olzhasmametov970-lab/HW2.00/hydrowin/hydrowin/hardware/enclosure/KOMPAS_BY_FUNCTIONS.md

# HydroWin — КОМПАС-3D по функциям

Инструкция по **операциям КОМПАС**: какая функция → что нажать → какие цифры ввести.

Две детали: **низ** (`hydrowin_base.m3d`) и **крышка** (`hydrowin_lid.m3d`).

---

## Быстрая шпаргалка размеров

| Что | Размер |
|---|---|
| Внешний корпус | 155.6 × 77.6 × 44.8 мм |
| Полость внутри | 150 × 72 × 42 мм |
| Стенка / дно | 2.8 мм |
| LilyGO | 110×34, стойки h=10 |
| DC-DC | 66×27, стойки h=4 |
| PG7 | Ø12.8 |
| BNC ×6 | Ø14, шаг 17.5 |
| Саморез крышки | Ø3.4 в крышке, пилот Ø2.3 в низе |

---

# ДЕТАЛЬ 1 — НИЗ КОРПУСА

## Функция 1: Создать деталь

```
Файл → Создать → Деталь
Файл → Сохранить как → hydrowin_base.m3d
```

---

## Функция 2: Эскиз (контур)

**Где:** плоскость **XY** (дно, Z=0).

```
Оформление → Эскиз
  (или: Эскиз → Создать эскиз на плоскости XY)
```

**Что нарисовать:**

| Инструмент | Действие |
|---|---|
| Прямоугольник | 155.6 × 77.6 мм, угол в (0, 0) |
| Размеры | Привязать к началу координат |

```
Эскиз → Завершить создание эскиза
```

---

## Функция 3: Тонкостенный элемент (корпус-оболочка)

```
Операции → Тонкостенный элемент → Выдавить
```

| Поле | Значение |
|---|---|
| Эскиз | только что созданный |
| Высота | **44.8** мм |
| Толщина стенки | **2.8** мм |
| Направление толщины | **внутрь** |

**Результат:** полость 150×72×42 мм.

> **Нет «тонкостенного»?**  
> Выдавливание дна 2.8 мм → на верхней грани эскиз 150×72 со смещением 2.8 → выдавить стенки 42 мм.

---

## Функция 4: Эскиз на плоскости стенки

Повторяется для каждого отверстия в стенке.

### 4а. PG7 — левая стенка (−X)

```
Эскиз → Плоскость грани левой стенки
```

| Параметр | Значение |
|---|---|
| Круг | **Ø12.8** |
| Центр Y | **20.3** |
| Центр Z | **4.55** |

### 4б. USB — левая стенка

| Параметр | Значение |
|---|---|
| Прямоугольник | **10 × 4** мм |
| Центр Y | **56.8** |
| Центр Z | **18.8** |

### 4в. BNC ×6 — задняя стенка (+Y)

| Параметр | Значение |
|---|---|
| Круг | **Ø14** |
| Z центра | **14.8** |
| X центров | 34.05 · 51.55 · 69.05 · 86.55 · 104.05 · 121.55 |

### 4г. SMA ×2 — задняя стенка

| Параметр | Значение |
|---|---|
| Круг | **Ø6.6** |
| Z | **34.8** |
| X | **30.8** и **124.8** |

---

## Функция 5: Выдавливание → Вырезать (сквозные отверстия)

После каждого эскиза на стенке:

```
Операции → Эскивание → Вырезать
```

| Поле | Значение |
|---|---|
| Глубина | **Сквозное** (через всю стенку) |
| Направление | перпендикулярно стенке |

Повторить для PG7, USB, 6× BNC, 2× SMA.

---

## Функция 6: Массив (копии BNC без ручного копирования)

Если рисовали **один** BNC:

```
Операции → Массив → Линейный массив
```

| Поле | Значение |
|---|---|
| Объект | вырез BNC |
| Направление | ось **X** |
| Количество | **6** |
| Шаг | **17.5** мм |
| Смещение первого | X = **34.05** |

> Или 6 отдельных эскизов по таблице X — надёжнее.

---

## Функция 7: Эскиз + Выдавливание → Присоединить (стойки)

**Плоскость:** дно полости (Z = 2.8).

### 7а. Стойки DC-DC (4 шт.)

```
Эскиз → 4 круга Ø6.5
```

| № | X | Y |
|---|---|---|
| 1 | 48.8 | 10.8 |
| 2 | 106.8 | 10.8 |
| 3 | 48.8 | 29.8 |
| 4 | 106.8 | 29.8 |

*(глоб. = внутр. + 2.8)*

```
Операции → Выдавливание → Присоединить
  Высота: 4 мм
  Направление: +Z
```

### 7б. Стойки LilyGO (4 шт.)

Те же операции, круги **Ø6.5**:

| № | X (глоб.) | Y (глоб.) |
|---|---|---|
| 1 | 26.8 | 43.8 |
| 2 | 128.8 | 43.8 |
| 3 | 26.8 | 69.8 |
| 4 | 128.8 | 69.8 |

```
Выдавливание → Присоединить
  Высота: 10 мм
```

---

## Функция 8: Выдавливание → Вырезать (отверстия M3 в стойках)

На верхней грани каждой стойки (или один эскиз со всеми 8 центрами):

```
Эскиз → 8 кругов Ø3.2 в центрах стоек
Операции → Выдавливание → Вырезать → Сквозное
```

---

## Функция 9: Эскиз + Вырезать (канавки в дне)

**Плоскость:** внутреннее дно полости (Z = 2.8).

Канавка = узкий прямоугольник в эскизе → вырез вниз.

### 9а. Питание 24V

| Параметр | Значение |
|---|---|
| Ширина эскиза | **2.6** мм |
| Глубина выреза | **3.0** мм |
| Трасса (центр. линия) | (13.8; 20.3) → (24.8; 20.3) → (24.8; 35) → (62.8; 33.8) |

```
Выдавливание → Вырезать
  Глубина: 3.0 мм
  Направление: −Z (в дно)
```

### 9б. Карман предохранителя

| Параметр | Значение |
|---|---|
| Прямоугольник | **14 × 42** мм |
| Позиция | X=8.8…22.8, Y≈0…42 (глоб.) |
| Глубина | **26** мм вверх (+Z) |

```
Выдавливание → Вырезать
  Направление: +Z (в полость)
```

### 9c. Линия 5V

| Параметр | Значение |
|---|---|
| Ширина | **2.3** |
| Глубина | **2.5** |
| Трасса | (106.8; 10.8) → (106.8; 39.8) → (34.8; 39.8) → (34.8; 47.8) |

### 9d. Сигнальные ×6

| Параметр | Значение |
|---|---|
| Ширина | **1.5** |
| Глубина | **1.8** |
| Шаг | **3.0** |
| X центров (глоб.) | 56.55 · 59.55 · 62.55 · 65.55 · 68.55 · 71.55 |
| Направление | от платы (Y≈74) к BNC (Y≈65) |

### 9e. Карман резистора (на каждой линии)

| Параметр | Значение |
|---|---|
| Размер | **8 × 3** мм |
| Глубина | **3.0** |
| Позиция | у кромки платы на каждой из 6 линий |

### 9f. Канавки BNC

| Параметр | Значение |
|---|---|
| Ширина | **3.0** |
| Глубина | **3.2** |
| Количество | 6 вертикальных к задней стенке |

---

## Функция 10: Скругление (Fillet) — повороты канавок

```
Операции → Сопряжение → Скругление
```

| Поле | Значение |
|---|---|
| Рёбра | внешние углы канавок на поворотах |
| Радиус | **R4** мм (минимум) |

> На эскизе канавки можно сразу рисовать с дугами R4.

---

## Функция 11: Эскиз + Вырезать (жалюзи DC-DC)

**Зона в полу:** X=47.8…107.8, Y=9.8…30.8 (глоб.).

```
Эскиз → несколько узких прямоугольников под углом 45°
  Толщина ламели (остаётся): 1.5 мм
  Зазор (вырезается): 2.0 мм
```

```
Выдавливание → Вырезать
  Глубина: 2.8 мм (сквозь дно) или 2.0 мм
```

*Ламели остаются — вырезаете только щели между ними.*

---

## Функция 12: Карман / паз (уплотнитель на буртике)

**Плоскость:** верхний торец стенок (Z = 44.8).

```
Эскиз → контур по периметру, отступ от края 4.2 мм
  Ширина паза: 2.8 мм
```

```
Выдавливание → Вырезать
  Глубина: 2.0 мм
  Направление: −Z
```

---

## Функция 13: Отверстие / вырез (пилоты под саморез)

**Плоскость:** верхний буртик.

```
Эскиз → 4 круга Ø2.3
```

| Угол | X | Y |
|---|---|---|
| 1 | 8 | 8 |
| 2 | 147.6 | 8 |
| 3 | 8 | 69.6 |
| 4 | 147.6 | 69.6 |

```
Выдавливание → Вырезать
  Глубина: 8 мм (НЕ сквозное)
```

---

## Функция 14: Сохранить деталь

```
Файл → Сохранить
```

---

# ДЕТАЛЬ 2 — КРЫШКА

## Функция 15: Создать деталь

```
Файл → Создать → Деталь → hydrowin_lid.m3d
```

---

## Функция 16: Эскиз + Присоединить (пластина)

```
Эскиз на XY → прямоугольник 155.6 × 77.6
Выдавливание → Присоединить → высота 3.2 мм
```

---

## Функция 17: Эскиз + Вырезать (губа)

**Плоскость:** нижняя грань крышки.

```
Эскиз → контур 150.7 × 72.7, смещение 2.45 от края
Выдавливание → Вырезать → глубина 2.0 мм вниз (−Z)
```

---

## Функция 18: Эскиз + Вырезать (отверстия крышки)

```
Эскиз → 4 круга Ø3.4 в углах (таблица из Функции 13)
Выдавливание → Вырезать → Сквозное
```

---

## Функция 19: Сохранить крышку

```
Файл → Сохранить
```

---

# СБОРКА

## Функция 20: Создать сборку

```
Файл → Создать → Сборка → hydrowin_asm.a3d
```

---

## Функция 21: Вставить компонент

```
Вставка → Компонент → Добавить из файла
  → hydrowin_base.m3d
  → hydrowin_lid.m3d
```

---

## Функция 22: Смещение / положение компонента

Выделить крышку:

```
Преобразования → Смещение (или Массив компонентов → Переместить)
  Ось Z: +44.8 мм
```

Проверить надевание на буртик.

---

## Функция 23: Измерение (контроль)

```
Измерения → Расстояние
```

| Что проверить | Должно быть |
|---|---|
| Внутренняя длина | 150 мм |
| Внутренняя ширина | 72 мм |
| PG7 напротив DC-DC | Y ≈ 20 |
| BNC на одной линии | Z = 14.8 |

---

## Функция 24: Экспорт STL (для печати)

```
Файл → Сохранить как → STL
```

| Деталь | Ориентация в слайсере |
|---|---|
| hydrowin_base | дном вниз |
| hydrowin_lid | внешней стороной вверх |

---

# Порядок операций (чеклист)

### Низ
- [ ] **1** Создать деталь
- [ ] **2–3** Эскиз + Тонкостенный элемент (корпус)
- [ ] **4–5** Эскизы на стенках + Вырезать (PG7, USB, BNC, SMA)
- [ ] **6** Массив BNC (опционально)
- [ ] **7–8** Стойки: Присоединить + Вырезать M3
- [ ] **9** Канавки и карманы: Вырезать
- [ ] **10** Скругление R4 на канавках
- [ ] **11** Жалюзи
- [ ] **12** Паз уплотнителя
- [ ] **13** Пилоты саморезов
- [ ] **14** Сохранить

### Крышка
- [ ] **15–16** Деталь + пластина
- [ ] **17** Губа
- [ ] **18** Отверстия Ø3.4
- [ ] **19** Сохранить

### Сборка
- [ ] **20–22** Сборка + вставка + смещение крышки
- [ ] **23** Измерения
- [ ] **24** STL → печать

---

# Схема (вид сверху, глоб. координаты)

```
  Y=77.6  ○SMA(30.8)              ○SMA(124.8)
          ○BNC  ○    ○    ○    ○    ○
  ┌──────────────────────────────────────────┐ X=155.6
  │         LilyGO  X=22.8…132.8             │
  │         DC-DC   X=44.8…110.8             │
  │                    ////жалюзи////         │
  └──────────────────────────────────────────┘
  ○PG7(12.8) Y=20.3          ○USB Y=56.8
  X=0
```

---

# Связанные файлы

| Файл | Содержание |
|---|---|
| [KOMPAS_CREATE_PART.md](KOMPAS_CREATE_PART.md) | Полные таблицы координат |
| [KOMPAS_ASSEMBLY.md](KOMPAS_ASSEMBLY.md) | Импорт готовых STL |
| [BUILD_FROM_SCRATCH.md](BUILD_FROM_SCRATCH.md) | OpenSCAD + печать |
| [POWER_WIRING.md](../../firmware/POWER_WIRING.md) | Проводка |
