olzhasmametov970-lab/HW2.00/hydrowin/hydrowin/hardware/enclosure/KOMPAS_CREATE_PART.md

# HydroWin — создать корпус в КОМПАС-3D с нуля

Полная инструкция: как **создать деталь**, нарисовать корпус, вырезать канавки и собрать.  
Все размеры взяты из модели проекта (`hydrowin_enclosure.scad`).

---

## Содержание

1. [Система координат](#1-система-координат)
2. [Сводная таблица размеров](#2-сводная-таблица-размеров)
3. [Деталь 1 — низ корпуса (base)](#3-деталь-1--низ-корпуса-base)
4. [Деталь 2 — крышка (lid)](#4-деталь-2--крышка-lid)
5. [Сборка](#5-сборка)
6. [Альтернатива — импорт STL](#6-альтернатива--импорт-stl)

---

## 1. Система координат

В КОМПАС при создании детали:

| Ось | Направление |
|---|---|
| **X** | Длина корпуса (150 мм внутри) |
| **Y** | Ширина (72 мм внутри) |
| **Z** | Высота (вверх) |

**Ноль (0,0,0)** — нижний левый внешний угол дна корпуса (передний левый угол при виде сбоку).

```
        Y (ширина 77.6)
        ↑
        │   ┌──────────────────┐  ← задняя стенка (BNC)
        │   │                  │
        └───┘                  │
       X (длина 155.6) ────────→

  Z вверх — от дна наружу
```

**Внутренняя полость** начинается в точке **(2.8 ; 2.8 ; 2.8)** — это смещение стенки и дна.

Все координаты ниже для **внутренней полости** даны **от внутреннего угла** (X=2.8, Y=2.8, Z=2.8).  
Чтобы получить **глобальную** координату КОМПАС: **прибавьте 2.8** к X, Y и Z.

---

## 2. Сводная таблица размеров

### Корпус

| Параметр | мм |
|---|---|
| Внутренняя длина × ширина × высота | **150 × 72 × 42** |
| Толщина стенок | **2.8** |
| Толщина дна | **2.8** |
| Внешние габариты низа | **155.6 × 77.6 × 44.8** |

### Платы (зоны монтажа)

| Компонент | Размер | Позиция (внутр. X, Y от угла полости) |
|---|---|---|
| DC-DC | 66 × 27 × 10 | X=42…108, Y=4…31 |
| LilyGO | 110 × 34 × 18 | X=20…130, Y=37…71 |

### Стойки M3

| | Ø наружный | Высота | Ø отверстия |
|---|---|---|---|
| Под LilyGO | 6.5 | **10** | 3.2 |
| Под DC-DC | 6.5 | **4** | 3.2 |

**Центры стоек LilyGO** (внутр. координаты):

| № | X | Y |
|---|---|---|
| 1 | 24 | 41 |
| 2 | 126 | 41 |
| 3 | 24 | 67 |
| 4 | 126 | 67 |

*(Если отверстия на вашей плате другие — замерьте и сдвиньте; в модели отступ от края PCB = 4 мм.)*

**Центры стоек DC-DC** (внутр. координаты):

| № | X | Y |
|---|---|---|
| 1 | 46 | 8 |
| 2 | 104 | 8 |
| 3 | 46 | 27 |
| 4 | 104 | 27 |

### Отверстия в стенках

| Элемент | Ø / размер | Позиция |
|---|---|---|
| **PG7** (левая стенка, −X) | **Ø12.8** | Y=**20.3**, Z=**4.55** (глоб.) |
| **USB** (левая стенка) | 10 × 4 мм | Y=**56.8**, Z=**18.8** (глоб.) |
| **BNC ×6** (задняя стенка, +Y) | **Ø14** | Z центра = **14.8** (глоб.) |
| **SMA LTE** | **Ø6.6** | X=**30.8**, Z=**34.8** (глоб.) |
| **SMA GPS** | **Ø6.6** | X=**124.8**, Z=**34.8** (глоб.) |

**BNC по X** (центры, внутр. координата → глоб. X = +2.8):

| BNC | Внутр. X | Глоб. X |
|---|---|---|
| 1 | 31.25 | 34.05 |
| 2 | 48.75 | 51.55 |
| 3 | 66.25 | 69.05 |
| 4 | 83.75 | 86.55 |
| 5 | 101.25 | 104.05 |
| 6 | 118.75 | 121.55 |

Шаг BNC: **17.5 мм**.

### Кабельные канавки (вырезать из дна полости)

| Линия | Ширина | Глубина |
|---|---|---|
| Питание 24V | 2.6 | 3.0 |
| 5V | 2.3 | 2.5 |
| Сигнал ×6 | 1.5 | 1.8 (шаг 3.0) |
| BNC | 3.0 | 3.2 |
| Скругление поворотов | R ≥ **4.0** | |

**Карман предохранителя:** 42 × 14 × 26 мм (внутр. X=6…20, Y≈−3.5…38.5 относительно pg7_y).  
**Карман резистора** (на каждой сигнальной линии): 8 × 3 × 3 мм.

### Крышка

| Параметр | мм |
|---|---|
| Пластина | 155.6 × 77.6 × **3.2** |
| Губа внутрь | глубина **2.0**, зазор **0.35** |
| Отверстия под саморез | **Ø3.4**, отступ от угла **8** |
| Пилоты в буртике низа | **Ø2.3**, глубина **8** |

### Жалюзи DC-DC (в полу)

| Параметр | мм |
|---|---|
| Зона | над DC-DC: X=45…105, Y=7…28 (внутр.) |
| Ламель | толщина **1.5** |
| Зазор | **2.0** |
| Угол | **45°** |

---

## 3. Деталь 1 — низ корпуса (base)

### Шаг 3.1. Создать деталь

1. Запустите **КОМПАС-3D**.
2. **Файл → Создать → Деталь** (или иконка «Новая деталь»).
3. **Файл → Сохранить как** → `hydrowin_base.m3d`.

### Шаг 3.2. Корпус-оболочка (тонкостенный или выдавливание)

**Способ A — тонкостенный элемент (удобнее):**

1. Плоскость **XY** (дно) → **Эскиз**.
2. Нарисуйте прямоугольник **155.6 × 77.6** мм (внешний контур).
3. **Операции → Тонкостенный элемент → Выдавить**.
4. Высота: **44.8** мм.
5. Толщина стенки: **2.8** мм, направление **внутрь**.

**Способ B — два выдавливания:**

1. Эскиз **155.6 × 77.6** → выдавить **2.8** мм (дно).
2. На верхней грани дна эскиз внутреннего контура **150 × 72** со смещением **2.8** от краёв.
3. Выдавить вверх **42** мм (стенки).

Проверка: внутренняя полость **150 × 72 × 42** мм.

### Шаг 3.3. Отверстие PG7 (24V, левая стенка)

1. Плоскость левой наружной стенки (или эскиз на YZ при X=0).
2. Точка центра: **Y = 20.3**, **Z = 4.55** мм (глобальные).
3. Круг **Ø12.8** мм.
4. **Операции → Выдавливание → Вырезать** сквозь стенку.

> Вокруг отверстия **не делайте** канавок на стенке в зоне **R10 мм** — нужна гладкая площадка под шайбу сальника.

### Шаг 3.4. Слот USB (левая стенка)

1. На той же стенке прямоугольник **10 × 4** мм.
2. Центр: **Y = 56.8**, **Z = 18.8** (глоб.).
3. Вырезать сквозь стенку.

### Шаг 3.5. Отверстия BNC (задняя стенка, Y = 77.6)

1. Плоскость задней стенки.
2. 6 кругов **Ø14** мм по таблице X выше.
3. Центр по высоте: **Z = 14.8** мм от низа детали.
4. Вырезать сквозь стенку.

### Шаг 3.6. Отверстия SMA (задняя стенка)

1. Два круга **Ø6.6** мм.
2. Центры: **(30.8 ; 77.6 ; 34.8)** и **(124.8 ; 77.6 ; 34.8)** (глоб.).
3. Сквозное вырезание.

### Шаг 3.7. Стойки под DC-DC

Для каждого из 4 центров (46,8), (104,8), (46,27), (104,27):

1. Эскиз круга **Ø6.5** на **дне полости** (плоскость Z = 2.8).
2. **Присоединить** → выдавить **4** мм вверх.
3. **Вырезать** в стойке отверстие **Ø3.2** сквозь.

### Шаг 3.8. Стойки под LilyGO

То же для центров (24,41), (126,41), (24,67), (126,67):

1. Круг **Ø6.5**.
2. Высота **10** мм.
3. Отверстие **Ø3.2**.

### Шаг 3.9. Канавка питания 24V

На **дне полости** (внутренняя горизонтальная грань, Z = 2.8):

1. Эскиз прямоугольника шириной **2.6** мм (или профиль канала).
2. Трасса (центральная линия):
   - от зоны PG7: **(11 ; 17.5)** → **(22 ; 17.5)** → **(22 ; центр кармана)** → **(60 ; 31)** (вход DC-DC).
3. **Вырезать** глубиной **3.0** мм вниз (в тело дна).
4. Повороты скруглить **R4**.

### Шаг 3.10. Карман предохранителя

1. На дне полости прямоугольник **14 × 42** мм (или 42 × 14 по ориентации).
2. Позиция: X=6…20, Y≈−3.5…38.5 от внутреннего угла (центр у PG7/DC-DC).
3. **Вырезать** глубиной **26** мм вверх в полость (карман открыт сверху).

### Шаг 3.11. Канавка 5V

- Ширина **2.3**, глубина **2.5**.
- От DC-DC **(104 ; 8)** → вверх по Y → к плате **(32 ; 37)**.
- Скругления R4.

### Шаг 3.12. 6 сигнальных канавок

- Ширина **1.5**, глубина **1.8**, шаг **3.0**.
- 6 параллельных линий от задней кромки платы (Y≈71) к линии BNC.
- Центры X: **53.75, 56.75, 59.75, 62.75, 65.75, 68.75** (внутр.).
- На каждой линии у платы — карман резистора **8 × 3 × 3** мм с плавным переходом.

### Шаг 3.13. Канавки к BNC

- Ширина **3.0**, глубина **3.2**.
- От шины сигналов вертикально к каждому BNC (6 шт.).

### Шаг 3.14. Жалюзи в полу (DC-DC)

1. На дне в зоне DC-DC вырежьте «окно» (или серию щелей).
2. Оставьте ламели **1.5** мм толщиной, зазор **2.0** мм, угол **45°**.
3. Ламели ориентируйте так, чтобы снизу не было прямого просмотра внутрь.

*Упрощение:* можно сделать 8–10 параллельных щелей под углом 45° в прямоугольнике 60×21 мм (X=45…105, Y=7…28 внутр.).

### Шаг 3.15. Паз под уплотнитель (буртик)

На верхнем торце стенок:

1. Паз шириной **2.8**, глубиной **2.0** мм.
2. Отступ от внешнего края **4.2** мм по периметру.

### Шаг 3.16. Пилоты под саморезы крышки

В верхнем буртике, от углов с отступом **8** мм:

1. 4 отверстия **Ø2.3** мм.
2. Глубина **8** мм (не сквозные).

### Шаг 3.17. Сохранить

**Файл → Сохранить** — `hydrowin_base.m3d`.

---

## 4. Деталь 2 — крышка (lid)

### Шаг 4.1. Новая деталь

**Файл → Создать → Деталь** → `hydrowin_lid.m3d`.

### Шаг 4.2. Пластина

1. Эскиз **155.6 × 77.6** на XY.
2. Выдавить **3.2** мм вверх.

### Шаг 4.3. Губа (внутренний борт)

1. На нижней грани эскиз контура **150.7 × 72.7** (150+0.35×2) со смещением **2.45** от края.
2. **Выдавить** вниз **2.0** мм (губа входит в полость).

### Шаг 4.4. Отверстия под саморезы

1. 4 круга **Ø3.4** мм.
2. Центры: **(8 ; 8)**, **(147.6 ; 8)**, **(8 ; 69.6)**, **(147.6 ; 69.6)** от угла детали.
3. Сквозное вырезание.

### Шаг 4.5. Сохранить

`hydrowin_lid.m3d`.

---

## 5. Сборка

1. **Файл → Создать → Сборка** → `hydrowin_asm.a3d`.
2. **Вставка → Компонент → Из файла** → `hydrowin_base.m3d`.
3. Вставить `hydrowin_lid.m3d`.
4. Сместить крышку по **Z = +44.8** мм (надеть на корпус) или **+2…3** мм (зазор для вида).
5. Проверить:
   - PG7 напротив DC-DC
   - BNC на одной линии
   - стойки внутри зон плат
6. **Сохранить сборку**.

### Проверка посадки плат (опционально)

Создайте временные блоки:

| Блок | Размер | Низ блока (Z) |
|---|---|---|
| DC-DC | 66×27×10 | 2.8+4 = **6.8** |
| LilyGO | 110×34×18 | 2.8+10 = **12.8** |

Если блок пересекает стенку — сдвиньте стойки.

---

## 6. Альтернатива — импорт STL

Если не хотите рисовать вручную — в проекте уже есть готовые STL:

```
hardware/enclosure/
  hydrowin_base.stl    ← низ
  hydrowin_lid.stl     ← крышка
```

**Вставка → Деталь → Из внешнего файла** → выбрать STL, единицы **мм**.

Пересборка STL из OpenSCAD:

```powershell
cd C:\Users\Admin2\Desktop\HW2.0\hydrowin\hydrowin\hardware\enclosure
.\export-stl.ps1
```

---

## Схема расположения (вид сверху, внутр. полость)

```
  задняя стенка Y=72
  ○SMA(28)              ○SMA(122)
  ○   ○   ○   ○   ○   ○   BNC
  ┌─────────────────────────────────────────┐  X=150
  │         [LilyGO 110×34]  Y=37…71        │
  │              X=20…130                   │
  │                                         │
  │         [DC-DC 66×27]  Y=4…31           │
  │              X=42…108   ////жалюзи////   │
  └─────────────────────────────────────────┘
  ○ PG7 Y=17.5          ○ USB Y=54
  левая стенка X=0
```

---

## Монтаж после печати / моделирования

Схема проводов и питания: [POWER_WIRING.md](../../firmware/POWER_WIRING.md)

| Шаг | Действие |
|---|---|
| 1 | DC-DC на 4 стойки, M3 |
| 2 | Предохранитель в карман, +24V |
| 3 | PG7 → IN DC-DC |
| 4 | LilyGO на стойки |
| 5 | 5V/GND на VIN |
| 6 | 6 линий датчиков |
| 7 | BNC, SMA, крышка |

---

## Частые вопросы

**Меню в КОМПАС отличается?**  
В разных версиях: «Эскиз» = «Создать эскиз», «Вырезать» = «Выдавливание → Вырезать». Логика та же.

**Отверстия платы не совпали?**  
Замерьте PCB, сдвиньте 4 стойки LilyGO в эскизе.

**Канавки задели стойку?**  
Оставляйте **≥1.5 мм** пластика между канавкой и стойкой/отверстием BNC.

**Печать из КОМПАС?**  
**Файл → Сохранить как → STL** → слайсер → дном вниз, PETG 0.2 мм.

---

## Связанные файлы проекта

| Документ | О чём |
|---|---|
| [BUILD_FROM_SCRATCH.md](BUILD_FROM_SCRATCH.md) | OpenSCAD + печать + сборка |
| [KOMPAS_ASSEMBLY.md](KOMPAS_ASSEMBLY.md) | Импорт готовых STL в сборку |
| [README.md](README.md) | Параметры канавок |
