olzhasmametov970-lab/HW2.00/hydrowin/hydrowin/website/web dns/CABINET.md

# Кабинет + API на Ubuntu

См. [`../CABINET.md`](../CABINET.md).

`app.hydrowin.ru` → `5.165.27.141` (Ubuntu Caddy).  
Лендинг `hydrowin.ru` — BeGet.
