olzhasmametov970-lab/HW2.00/hydrowin/hydrowin/hardware/enclosure/hydrowin_standoffs_board.stl

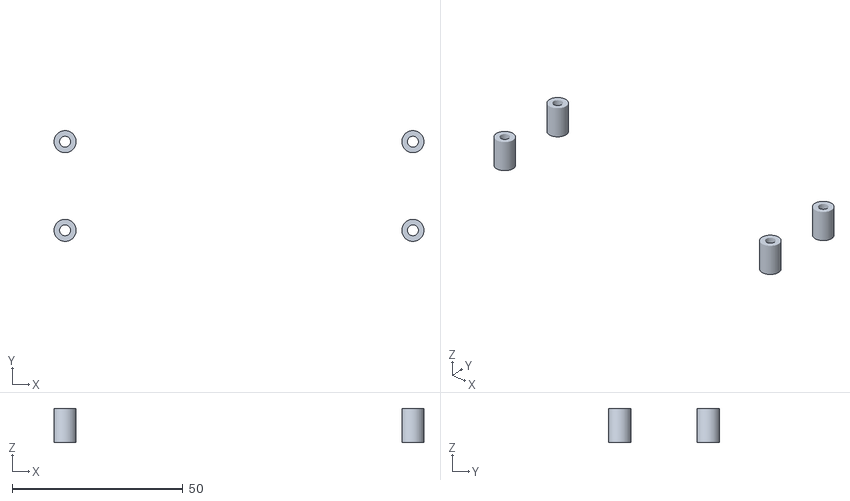
[picture p1: CAD file, 2026-09-04]
hydrowin/hydrowin/hardware/enclosure/hydrowin_standoffs_board.stl
108.5 x 32.5 x 10.0
