olzhasmametov970-lab/HW2.00/hydrowin/hydrowin/hardware/enclosure/_test.stl

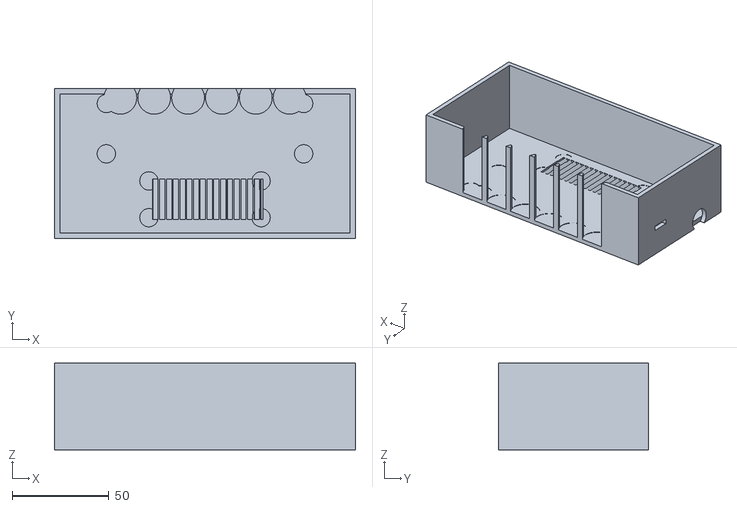
[picture p2: CAD file, 2026-09-04]
hydrowin/hydrowin/hardware/enclosure/_test.stl
155.6 x 77.6 x 44.8
