olzhasmametov970-lab/HW2.00/hydrowin/hydrowin/hardware/enclosure/hydrowin_standoffs_dcdc.stl

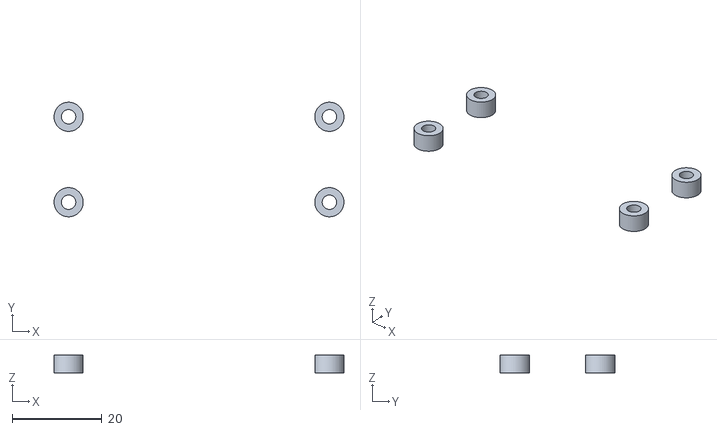
[picture p3: CAD file, 2026-09-04]
hydrowin/hydrowin/hardware/enclosure/hydrowin_standoffs_dcdc.stl
64.5 x 25.5 x 4.00
