olzhasmametov970-lab/HW2.00/hydrowin/hydrowin/hardware/enclosure/hydrowin_lid.stl

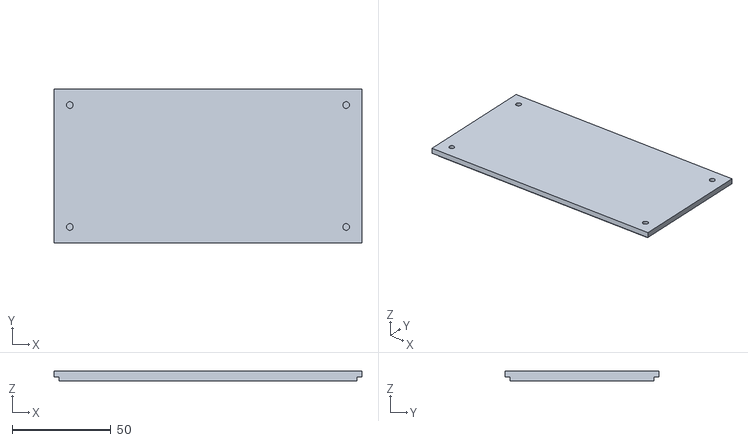
[picture p4: CAD file, 2026-09-04]
hydrowin/hydrowin/hardware/enclosure/hydrowin_lid.stl
155.6 x 77.6 x 5.20
