olzhasmametov970-lab/HW2.00/hydrowin/hydrowin/hardware/enclosure/hydrowin_shell.stl

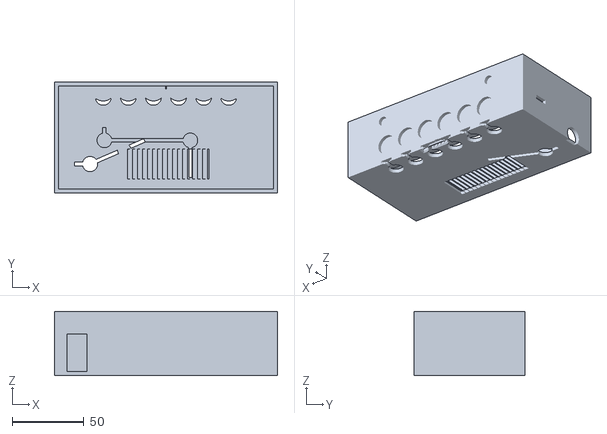
[picture p6: CAD file, 2026-09-04]
hydrowin/hydrowin/hardware/enclosure/hydrowin_shell.stl
155.6 x 77.6 x 44.8
