olzhasmametov970-lab/HW2.00/hydrowin/hydrowin/hardware/enclosure/hydrowin_standoffs_board.scad

include <hydrowin_enclosure.scad>
board_standoffs();
