olzhasmametov970-lab/HW2.00/hydrowin/hydrowin/hardware/enclosure/hydrowin_base.scad

include <hydrowin_enclosure.scad>
base_body();
