olzhasmametov970-lab/HW2.00/hydrowin/hydrowin/hardware/enclosure/hydrowin_lid.scad

include <hydrowin_enclosure.scad>
lid_body();
