olzhasmametov970-lab/HW2.00/hydrowin/hydrowin/hardware/enclosure/hydrowin_shell.scad

include <hydrowin_enclosure.scad>
shell_body();
