olzhasmametov970-lab/HW2.00/hydrowin/hydrowin/hardware/enclosure/hydrowin_standoffs_dcdc.scad

include <hydrowin_enclosure.scad>
dcdc_standoffs();
