olzhasmametov970-lab/HW2.00/hydrowin/hydrowin/firmware/esp32_ingest/tls_certs.h

/*
 * Root CA for HTTPS API (Let's Encrypt ISRG Root X1).
 * Lab without verify: #define TLS_INSECURE 1 in config.h
 */
#ifndef TLS_CERTS_H
#define TLS_CERTS_H

static const char TLS_ROOT_CA_ISRG_X1[] = R"EOF(
-----BEGIN CERTIFICATE-----
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
-----END CERTIFICATE-----
)EOF";

#endif // TLS_CERTS_H
