olzhasmametov970-lab/HW2.00/hydrowin/hydrowin/backend/app/database.py

from sqlalchemy import create_engine
from sqlalchemy.orm import DeclarativeBase, sessionmaker

from app.config import settings

engine = create_engine(
    settings.database_url,
    pool_pre_ping=True,
    pool_size=settings.db_pool_size,
    max_overflow=settings.db_max_overflow,
    pool_timeout=settings.db_pool_timeout_seconds,
)
SessionLocal = sessionmaker(autocommit=False, autoflush=False, bind=engine)


class Base(DeclarativeBase):
    pass


def get_db():
    db = SessionLocal()
    try:
        yield db
    finally:
        db.close()
