olzhasmametov970-lab/HW2.00/hydrowin/hydrowin/backend/app/security_middleware.py

"""Security headers + отказ от лишних сведений в ответах."""

from starlette.middleware.base import BaseHTTPMiddleware
from starlette.requests import Request
from starlette.responses import Response


class SecurityHeadersMiddleware(BaseHTTPMiddleware):
    async def dispatch(self, request: Request, call_next) -> Response:
        response = await call_next(request)
        response.headers.setdefault("X-Content-Type-Options", "nosniff")
        response.headers.setdefault("X-Frame-Options", "DENY")
        response.headers.setdefault("Referrer-Policy", "no-referrer")
        response.headers.setdefault(
            "Permissions-Policy",
            "geolocation=(), microphone=(), camera=()",
        )
        response.headers.setdefault(
            "Cache-Control",
            "no-store",
        )
        # HSTS имеет смысл только за HTTPS (nginx/caddy).
        if request.url.scheme == "https":
            response.headers.setdefault(
                "Strict-Transport-Security",
                "max-age=31536000; includeSubDomains",
            )
        return response
