olzhasmametov970-lab/HW2.00/(commit log)

2026-08-30 Remove committed secrets from repository.
    Strip device keys and Wi-Fi passwords from firmware configs, delete serial
    logs and BLE restore backups, move Telegram/CARTO keys to environment.
2026-09-04 Harden security, drop legacy WS/iot_server, and sync firmware/mobile.
    BLE PIN auth, media JWT, device-key pepper, remove lab WebSocket path and dead SCADA stack so GitHub matches the current HydroWin tree for cloud/mobile agents.
    [_test.stl, cable_routing.scad, hydrowin_base.scad, hydrowin_base.stl, hydrowin_enclosure.scad, hydrowin_lid.scad, hydrowin_lid.stl, hydrowin_shell.scad]
